LZolldann/Beer_Counter/Dokumentation/Papierliste.JPG

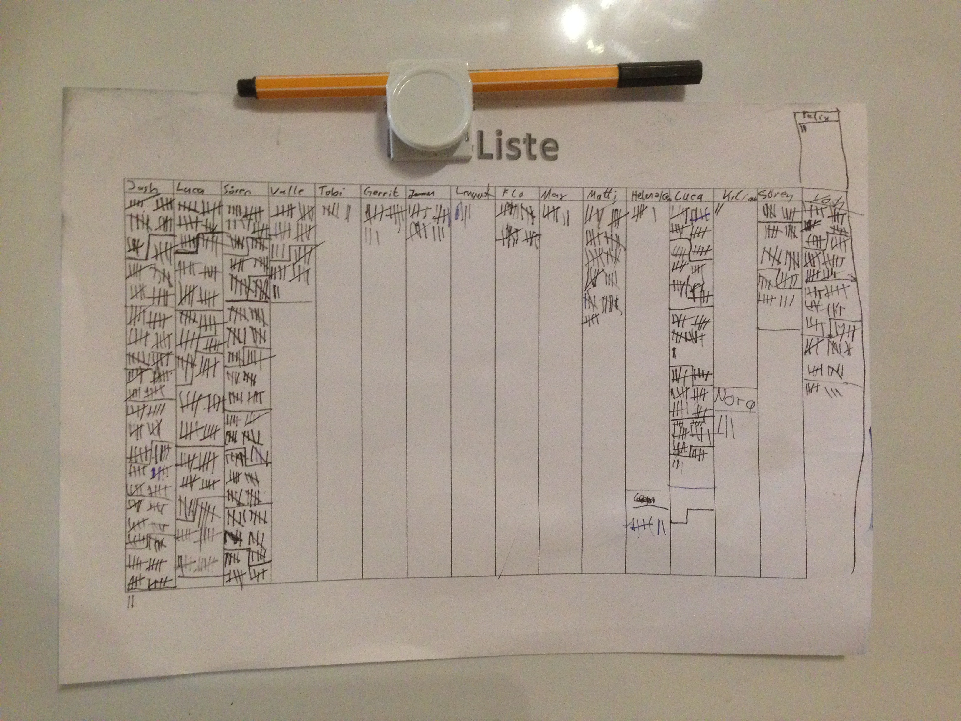
Dokumentation/Papierliste.JPG
