LZolldann/Beer_Counter/Dokumentation/Front.JPG

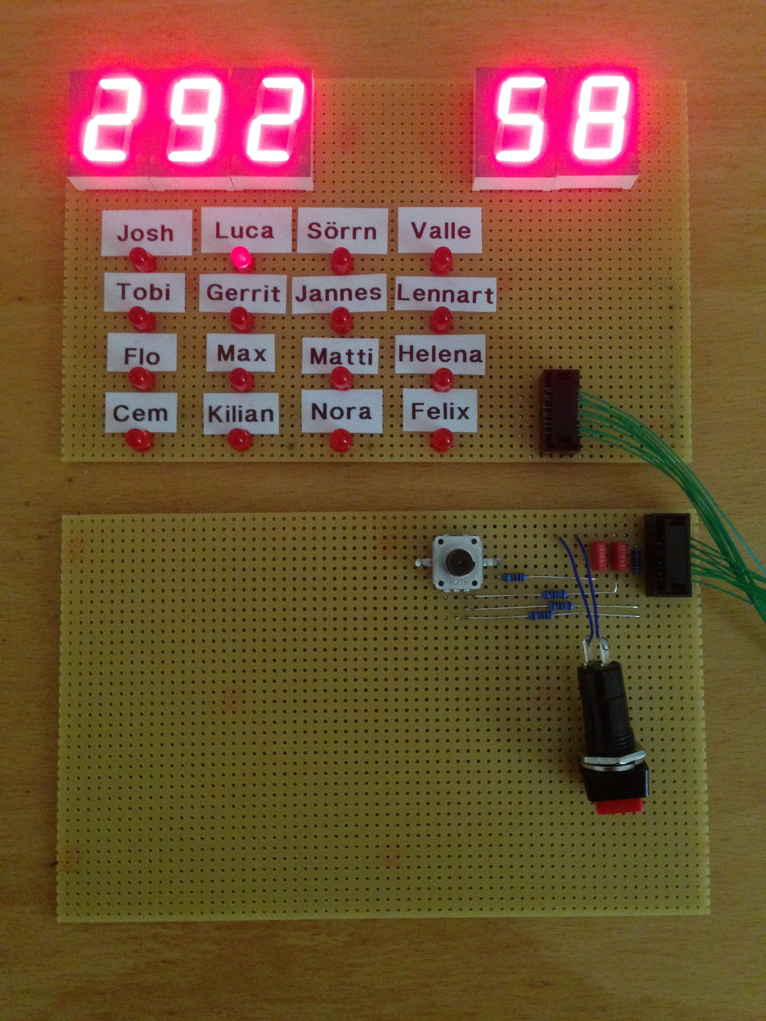
Dokumentation/Front.JPG
