LZolldann/Beer_Counter/Dokumentation/Gesamt.JPG

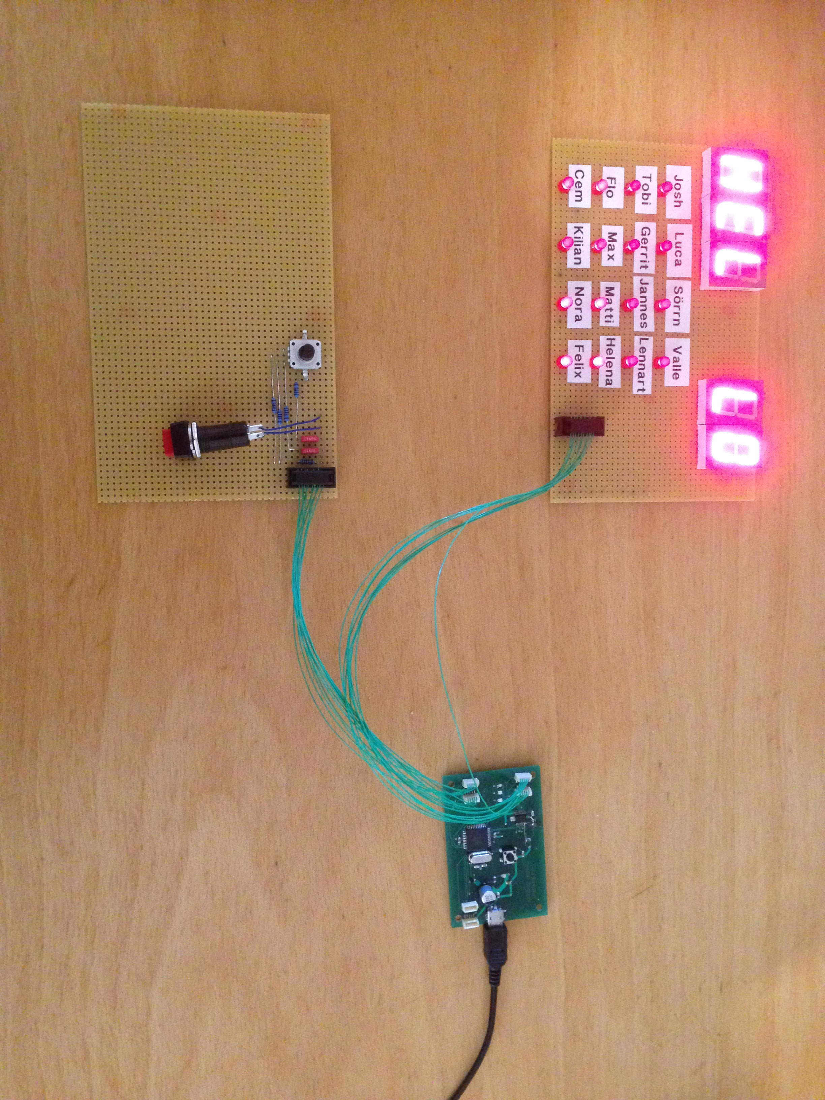
Dokumentation/Gesamt.JPG
