LZolldann/Beer_Counter/Dokumentation/Input.JPG

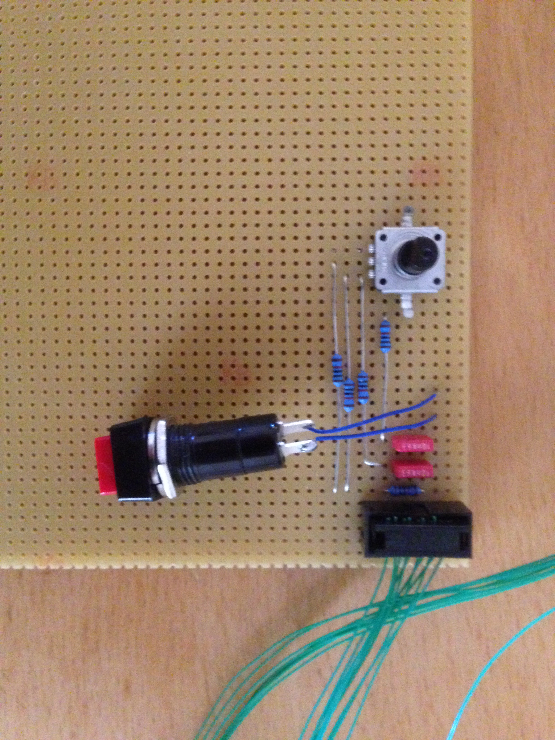
Dokumentation/Input.JPG
