LZolldann/Beer_Counter/Dokumentation/Linksdrehen.JPG

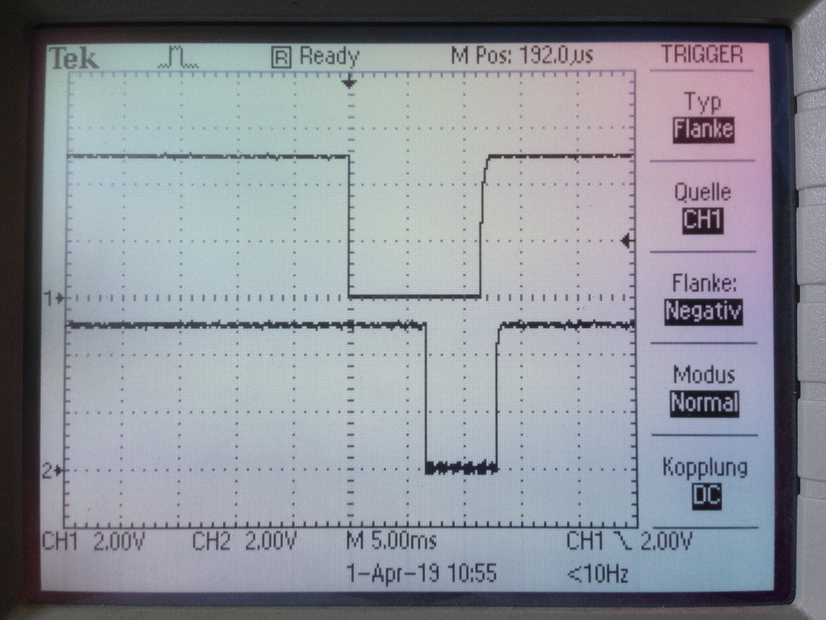
Dokumentation/Linksdrehen.JPG
