LZolldann/Beer_Counter/Dokumentation/Output.JPG

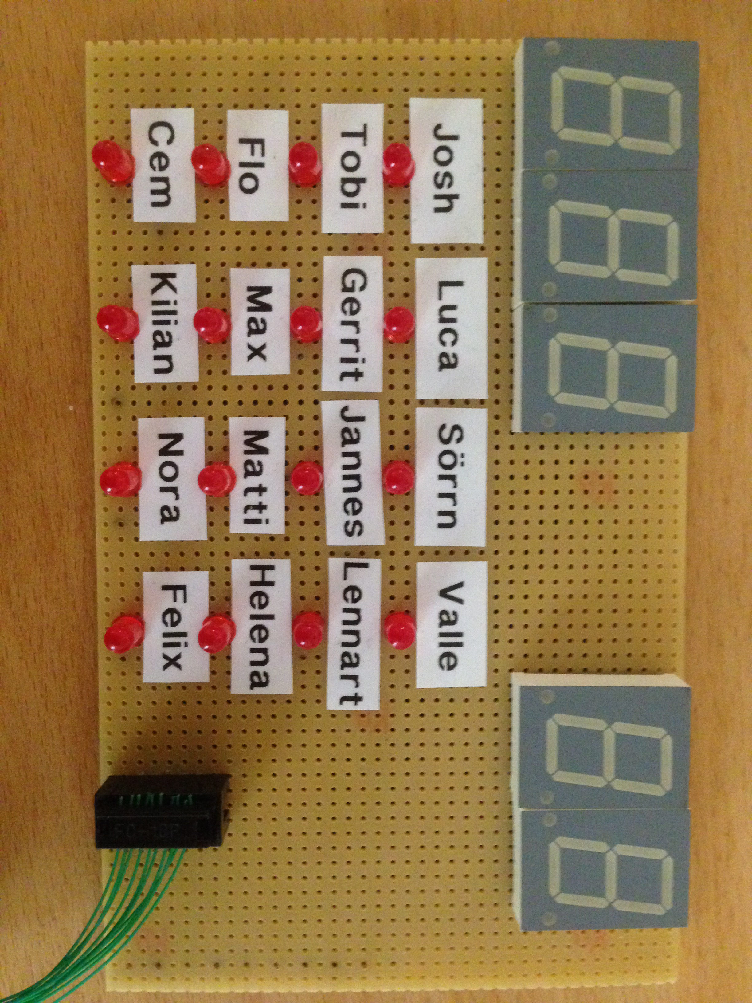
Dokumentation/Output.JPG
