LZolldann/Beer_Counter/Dokumentation/Rechtsdrehen.JPG

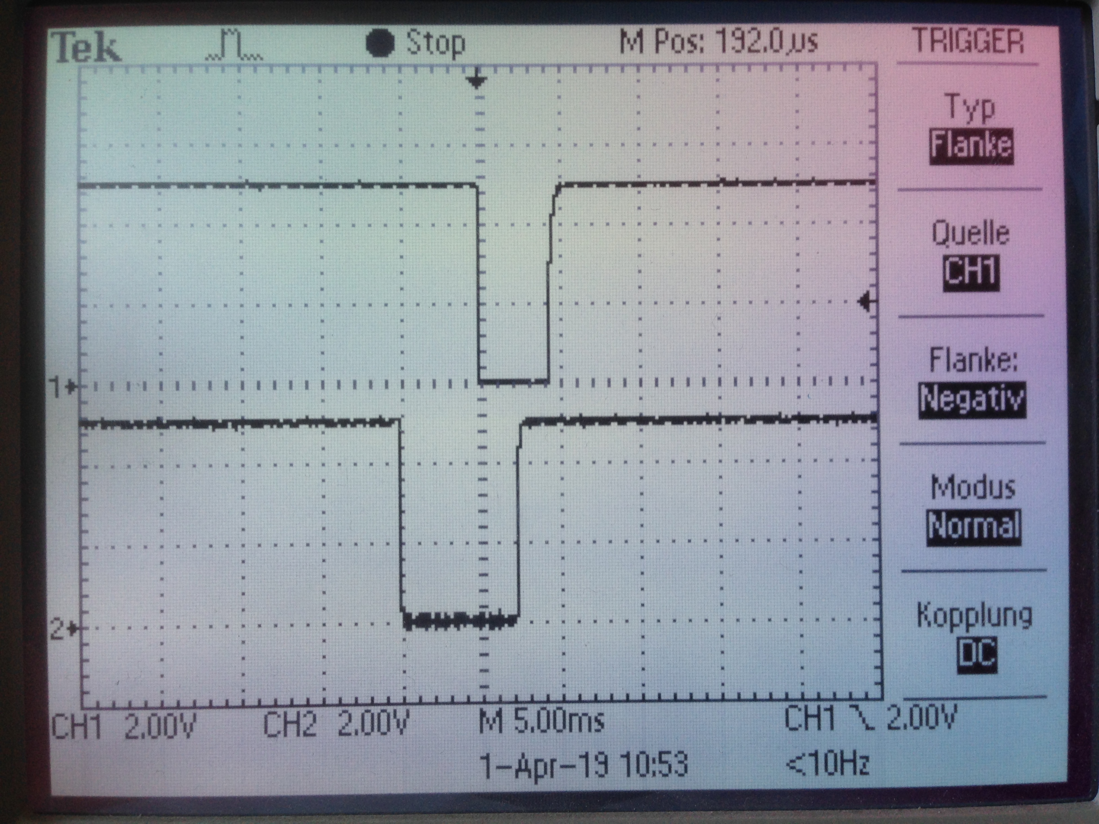
Dokumentation/Rechtsdrehen.JPG
