LZolldann/Beer_Counter/Dokumentation/Verschaltung Anschluss Input.PNG

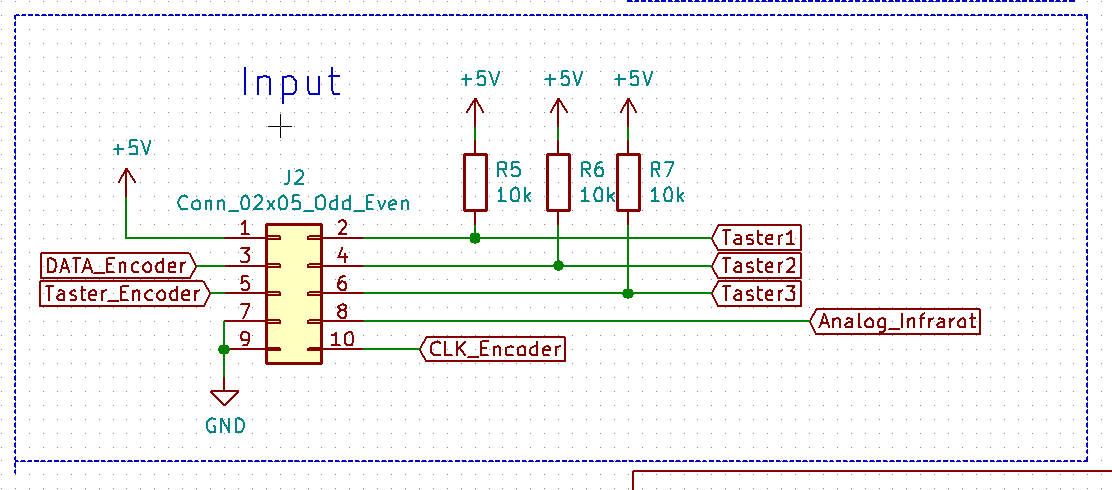
Dokumentation/Verschaltung Anschluss Input.PNG
