LZolldann/Beer_Counter/Dokumentation/Verschaltung µC.PNG

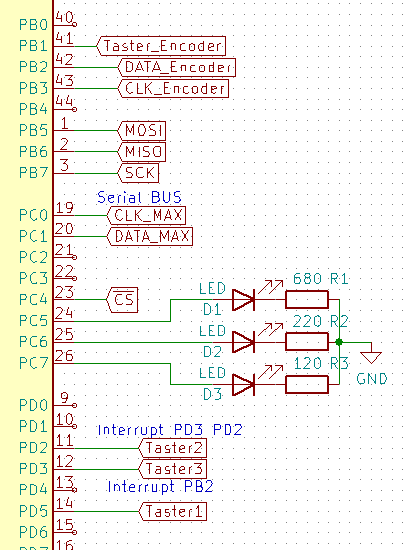
Dokumentation/Verschaltung µC.PNG
