LZolldann/Beer_Counter/(list of files, cad)

Other CAD files:
Code/Test.obj
