LZolldann/Beer_Counter/Code/Erstellung_Liste.asm

;Listenerstellung, vor Benutzung aktualisieren
.include "m16def.inc"
.org 0

;Initialisierung
ldi R16, LOW(RAMEND)
out SPL, R16
ldi R16, HIGH(RAMEND)
out SPH, R16
ldi R16, 0b11111111
out DDRC, R16
ldi R16, 0b01010000
out PORTC, R16

;Startbedingungen Liste

;Josh
ldi ZH, high($0000)
ldi ZL, low($0000)
ldi R16, 74
rcall EEPROM_write
ldi R16, 111
rcall EEPROM_write
ldi R16, 115
rcall EEPROM_write
ldi R16, 104
rcall EEPROM_write
ldi R16, 0
rcall EEPROM_write
rcall EEPROM_write
rcall EEPROM_write
rcall EEPROM_write
rcall EEPROM_write
rcall EEPROM_write
rcall EEPROM_write
rcall EEPROM_write
ldi R16, 1
rcall EEPROM_write
ldi R16, 47
rcall EEPROM_write
ldi R16, 1
rcall EEPROM_write
ldi R16, 44
rcall EEPROM_write

;Luca
ldi ZL, low($0010)
ldi R16, 76
rcall EEPROM_write
ldi R16, 117
rcall EEPROM_write
ldi R16, 99
rcall EEPROM_write
ldi R16, 97
rcall EEPROM_write
ldi R16, 0
rcall EEPROM_write
rcall EEPROM_write
rcall EEPROM_write
rcall EEPROM_write
rcall EEPROM_write
rcall EEPROM_write
rcall EEPROM_write
rcall EEPROM_write
ldi R16, 1
rcall EEPROM_write
ldi R16, 18
rcall EEPROM_write
ldi R16, 1
rcall EEPROM_write
ldi R16, 69
rcall EEPROM_write

;Soerrn
ldi ZL, low($0020)
ldi R16, 83
rcall EEPROM_write
ldi R16, 111
rcall EEPROM_write
ldi R16, 101
rcall EEPROM_write
ldi R16, 114
rcall EEPROM_write
rcall EEPROM_write
ldi R16, 110
rcall EEPROM_write
ldi R16, 0
rcall EEPROM_write
rcall EEPROM_write
rcall EEPROM_write
rcall EEPROM_write
rcall EEPROM_write
rcall EEPROM_write
ldi R16, 0
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

;Routine zum Schreiben der Werte in R16 in den EEPROM an Adresse in Register Z und verschiebt diese um 1
EEPROM_write:
sbic EECR, EEWE
rjmp EEPROM_write
out EEARH, ZH
out EEARL, ZL
out EEDR, r16
cli
sbi EECR, EEMWE
sbi EECR, EEWE
sei
inc ZL
brne OK
inc ZH
OK: ret

;Dauerwarten
end:
rjmp end
