LZolldann/Beer_Counter/(commit log)

2020-11-09 latest clean working
    sorted folder structure and integrated latest smooth and clean working version
    [Test.obj]
2020-11-09 working 1000 with blink
    The binary visualization of ever 1000 beer should work stable and also the blinking show for the 1000th beer works, but there are some 'random' bugs while handling as sometimes the buttons don't react and µC doesn't enter sleep mode. Probably this is caused by unintended interrupts from turning-nob...
    [Prüfsumme_Intel_Hex.xlsx, Test.obj]
2020-11-09 fixed problems
    Problem was really about unintended interrupts and now solved via 'awake-request'. Really wondering why this doesn't happen in earlier versions
    [Test.obj]
2020-11-10 changed the use of green LED
    Deleted all 'cbi PORTC, 6' except for in 'wait' before sleep. Also deleted 'sbi PORTC, 6' except for in 'init_first'. This way the green LED signalize the awake-state of the µC.
    [Test.obj]
